Artekit/ak-cmsis-dap-hw/AK-CMSIS-DAP_V1.3.brd

## EAGLE design AK-CMSIS-DAP_V1.3.brd (2018-01-13)

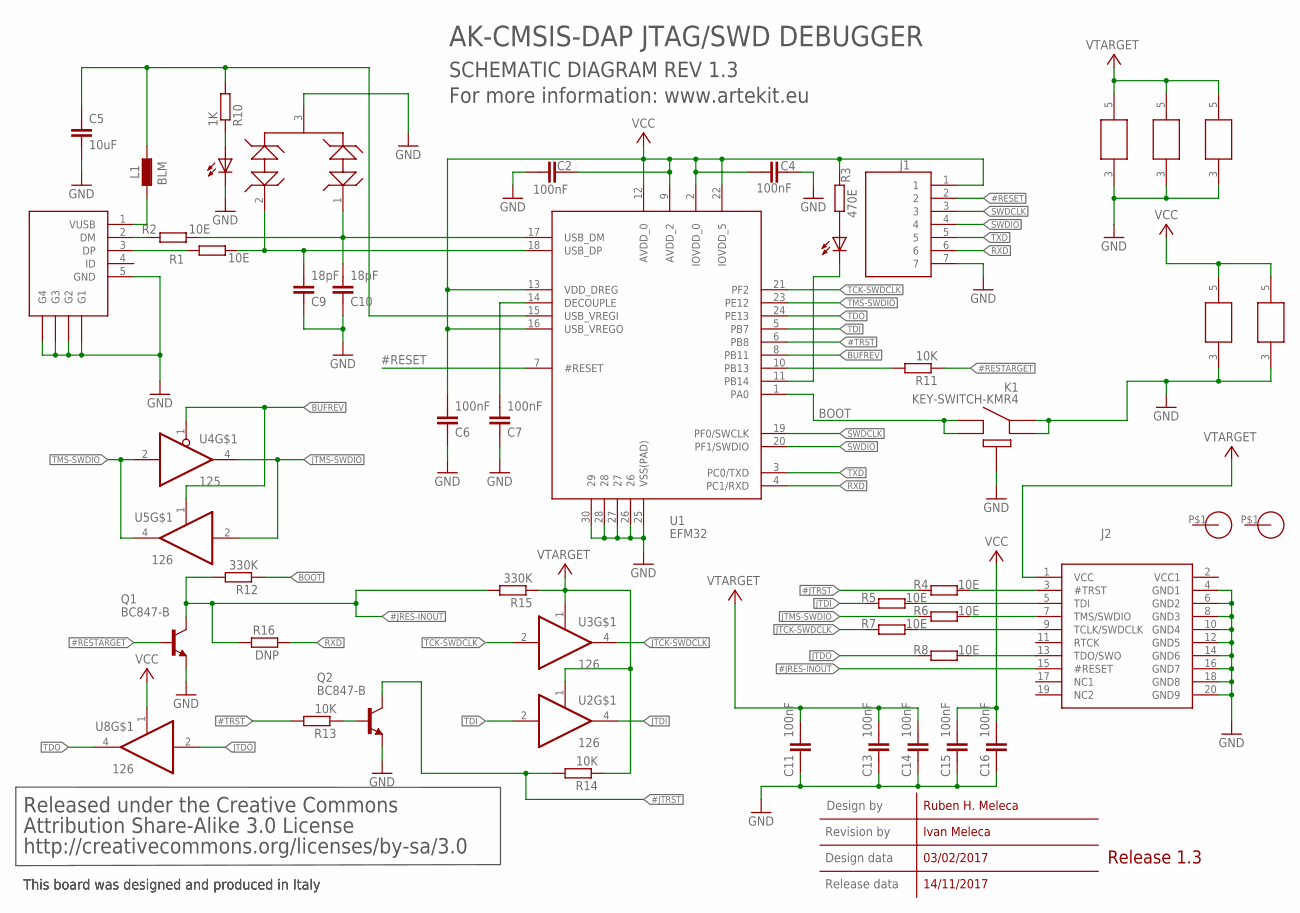
[picture p1: schematic AK-CMSIS-DAP_V1.3.sch]

Parts:
C2, C4, C6, C7, C11, C13, C14, C15, C16: 100nF; C0603
C5: 10uF; C0805
C9, C10: 18pF; C0603
D1: D5V0L; SOT-23-3
J1: CON-PH-1X07-P0.1"1; PIN-HEADER-1X07
J2: CONN-JTAG-20PIN-SMD; PIN-HEADER-2X10-WURTH
K1: KEY-SWITCH-KMR4; KEY-SWITCH-KMR-SERIES
L1: BLM; I0603
Q1, Q2: BC847-B; SOT-23-3
R1, R2, R4, R5, R6, R7, R8: 10E; R0603
R3: 470E; R0603
R10: 1K; R0603
R11, R13, R14: 10K; R0603
R12, R15: 330K; R0603
R16: DNP; R0603
U1: EFM32; QFN24-5X5-P0.65; MPN EFM32HG308F64G-B-QFN24
U2, U3, U5, U8: 126; SOT363-5
U4: 125; SOT363-5
U$1: CON-USB-MINI-B-SMD; MPN 690-005-299-043
U$2, U$4: LED0603-RED; CHIPLED_0603
U$3, U$5: FIDUTIAL_1.2MM

Connections:
#JRES-INOUT: J2.15 (#RESET), Q1.3, R12.2, R15.2, R16.2
#JTRST: Q2.3, R4.2, R14.2
#RESET: J1.2, U1.7 (#RESET)
#RESTARGET: Q1.1, R11.1
#TRST: R13.2, U1.6 (PB8)
BOOT: K1.3, K1.4, R12.1, U1.1 (PA0)
BUFREV: U1.8 (PB11), U4.1 (EN), U5.1 (EN)
GND: C2.1, C4.2, C5.2, C6.1, C7.1, C9.1, C10.1, C11.1, C13.1, C14.1, C15.1, C16.1, D1.3, J1.7, J2.4 (GND1), J2.6 (GND2), J2.8 (GND3), J2.10 (GND4), J2.12 (GND5), J2.14 (GND6), J2.16 (GND7), J2.18 (GND8), J2.20 (GND9), K1.1, K1.2, K1.5, Q1.2, Q2.2, U1.25 (VSS(PAD)), U1.26, U1.27, U1.28, U1.30 (29), U2.3 (GND), U3.3 (GND), U4.3 (GND), U5.3 (GND), U8.3 (GND), U$1.5 (GND), U$1.C (G1), U$1.D (G2), U$1.E (G3), U$1.F (G4), U$2.C
JTCK-SWDCLK: R7.2, U3.4 (O)
JTDI: R5.2, U2.4 (O)
JTDO: R8.2, U8.2 (I)
JTMS-SWDIO: R6.2, U4.4 (O), U5.2 (I)
unnamed: R2.1, U$1.2 (DM)
unnamed: R1.1, U$1.3 (DP)
unnamed: C10.2, D1.1, R2.2, U1.17 (USB_DM)
unnamed: C9.2, D1.2, R1.2, U1.18 (USB_DP)
unnamed: L1.1, U$1.1 (VUSB)
unnamed: C5.1, L1.2, R10.2, U1.15 (USB_VREGI)
unnamed: C7.2, U1.14 (DECOUPLE)
unnamed: J2.3 (#TRST), R4.1
unnamed: R3.1, U$4.A
unnamed: J2.5 (TDI), R5.1
unnamed: U1.11 (PB14), U$4.C
unnamed: J2.7 (TMS/SWDIO), R6.1
unnamed: J2.9 (TCLK/SWDCLK), R7.1
unnamed: J2.13 (TDO/SWO), R8.1
unnamed: R10.1, U$2.A
unnamed: R11.2, U1.10 (PB13)
unnamed: Q2.1, R13.1
RXD: J1.6, R16.1, U1.4 (PC1/RXD)
SWDCLK: J1.3, U1.19 (PF0/SWCLK)
SWDIO: J1.4, U1.20 (PF1/SWDIO)
TCK-SWDCLK: U1.21 (PF2), U3.2 (I)
TDI: U1.5 (PB7), U2.2 (I)
TDO: U1.24 (PE13), U8.4 (O)
TMS-SWDIO: U1.23 (PE12), U4.2 (I), U5.4 (O)
TXD: J1.5, U1.3 (PC0/TXD)
VCC: C2.2, C4.1, C6.2, C15.2, C16.2, J1.1, R3.2, U1.2 (IOVDD_0), U1.9 (AVDD_2), U1.12 (AVDD_0), U1.13 (VDD_DREG), U1.16 (USB_VREGO), U1.22 (IOVDD_5), U5.5 (VCC), U8.1 (EN), U8.5 (VCC)
VTARGET: C11.2, C13.2, C14.2, J2.1 (VCC), R14.1, R15.1, U2.1 (EN), U2.5 (VCC), U3.1 (EN), U3.5 (VCC), U4.5 (VCC)

Notes on the sheet:
AK-CMSIS-DAP JTAG/SWD DEBUGGER
SCHEMATIC DIAGRAM REV 1.3
For more information: www.artekit.eu
This board was designed and produced in Italy
Released under the Creative Commons
Attribution Share-Alike 3.0 License
http://creativecommons.org/licenses/by-sa/3.0
03/02/2017
14/11/2017
Ivan Meleca
Ruben H. Meleca
Design by
Revision by
Design data
Release data
Release 1.3

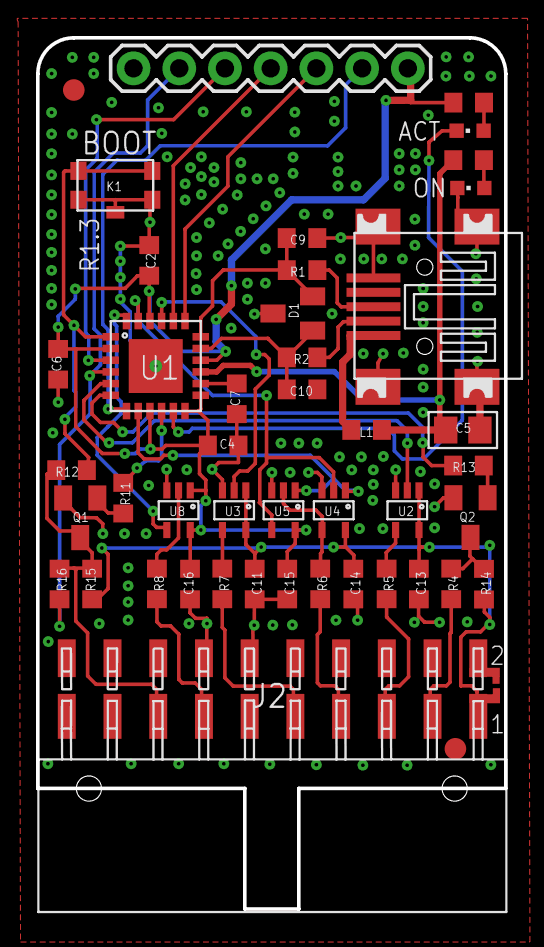
[picture p2: board AK-CMSIS-DAP_V1.3.brd from above]

Board: 2 copper layers, 26.0 x 48.4 mm, 45 parts (0 on the bottom side), 39 nets.
